openrevoltse/Open-Revolt-SE/Projeto Open revolt SE - Controlador Cougar/Manuais e Imagens/Circuito de Sobrevelocidade.jpg

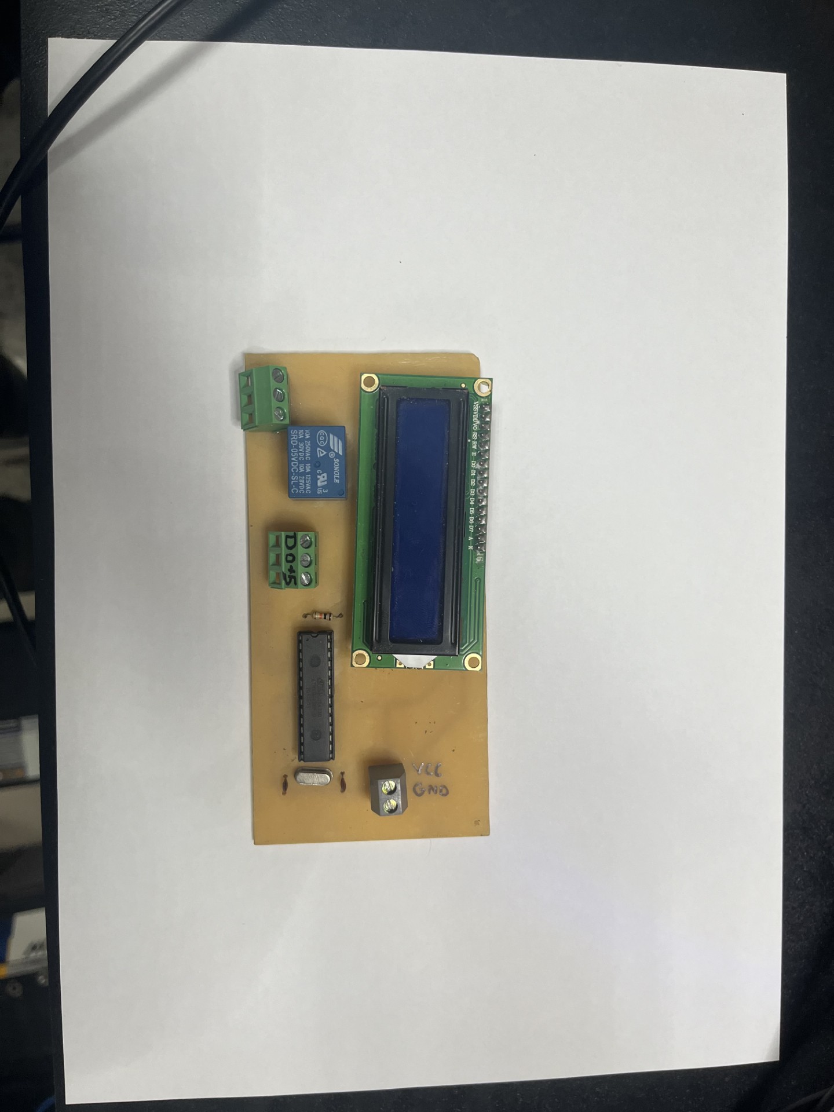
Projeto Open revolt SE - Controlador Cougar/Manuais e Imagens/Circuito de Sobrevelocidade.jpg
