openrevoltse/Open-Revolt-SE/Projeto Open revolt SE - Controlador Cougar/Esquemáticos/Proteção de Sobrevelocidade/Esquema Tacometro parte 2 - Copia.pdf

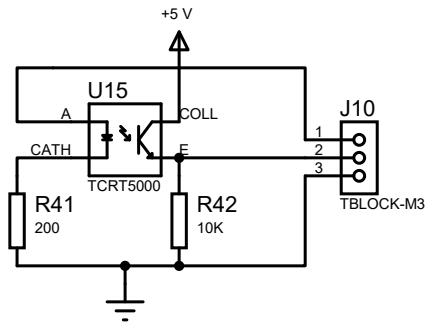
[picture p3: figure]
CATH; COLL; TCRT5000; TBLOCK-M3
