openrevoltse/Open-Revolt-SE/Projeto Open revolt SE - Controlador Cougar/Manuais e Imagens/Compirmento Bobinas rotor.jpg

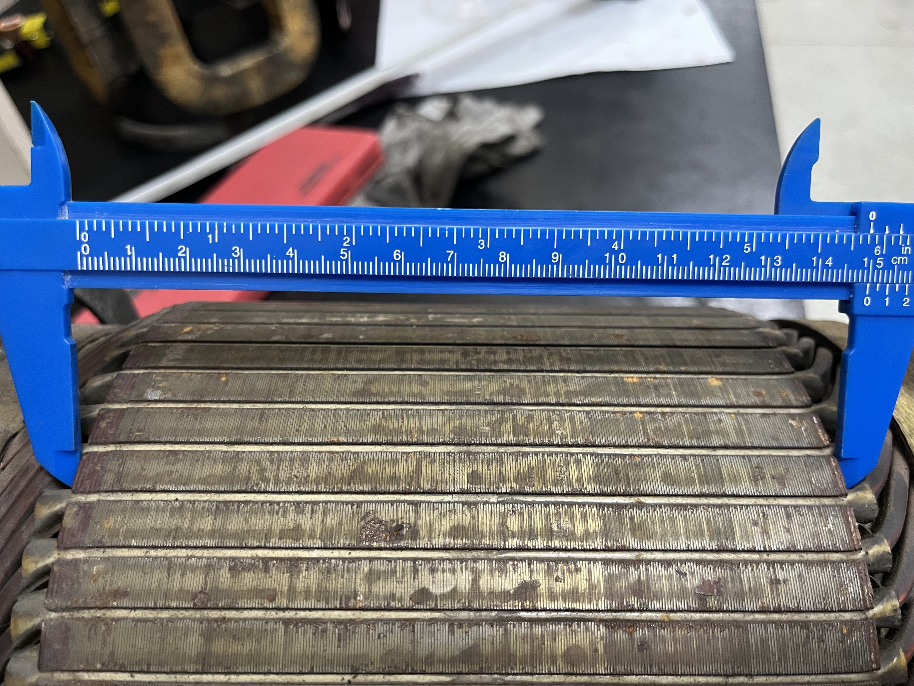
Projeto Open revolt SE - Controlador Cougar/Manuais e Imagens/Compirmento Bobinas rotor.jpg
