openrevoltse/Open-Revolt-SE/Projeto Open revolt SE - Controlador Cougar/Manuais e Imagens/Espessura lamina do rotor.JPG

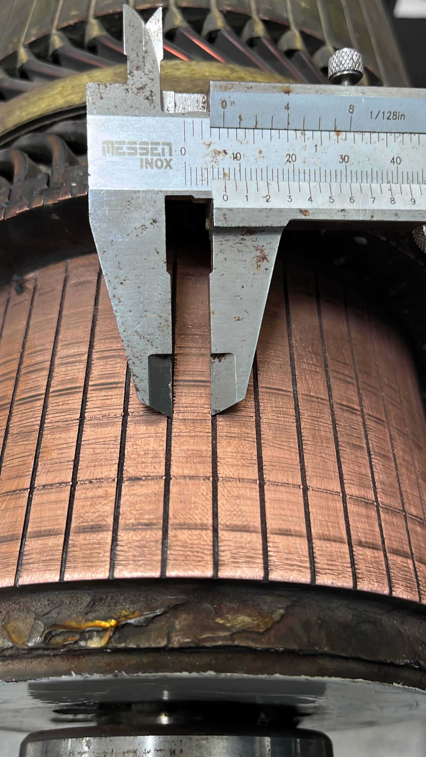
Projeto Open revolt SE - Controlador Cougar/Manuais e Imagens/Espessura lamina do rotor.JPG
