openrevoltse/Open-Revolt-SE/Projeto Open revolt SE - Controlador Cougar/Manuais e Imagens/frente circuito de potencia com dissipador.jpg

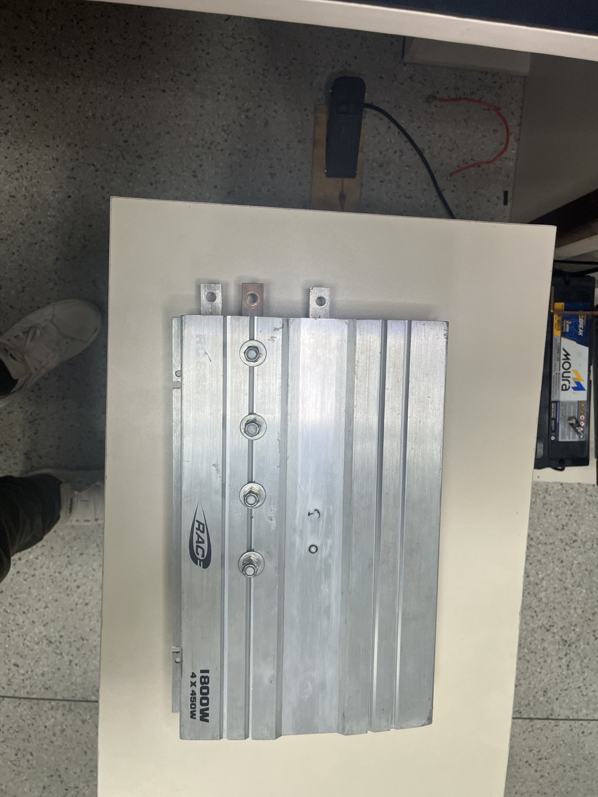
Projeto Open revolt SE - Controlador Cougar/Manuais e Imagens/frente circuito de potencia com dissipador.jpg
