openrevoltse/Open-Revolt-SE/Projeto Open revolt SE - Controlador Cougar/Manuais e Imagens/Mosfets na PCB.jpg

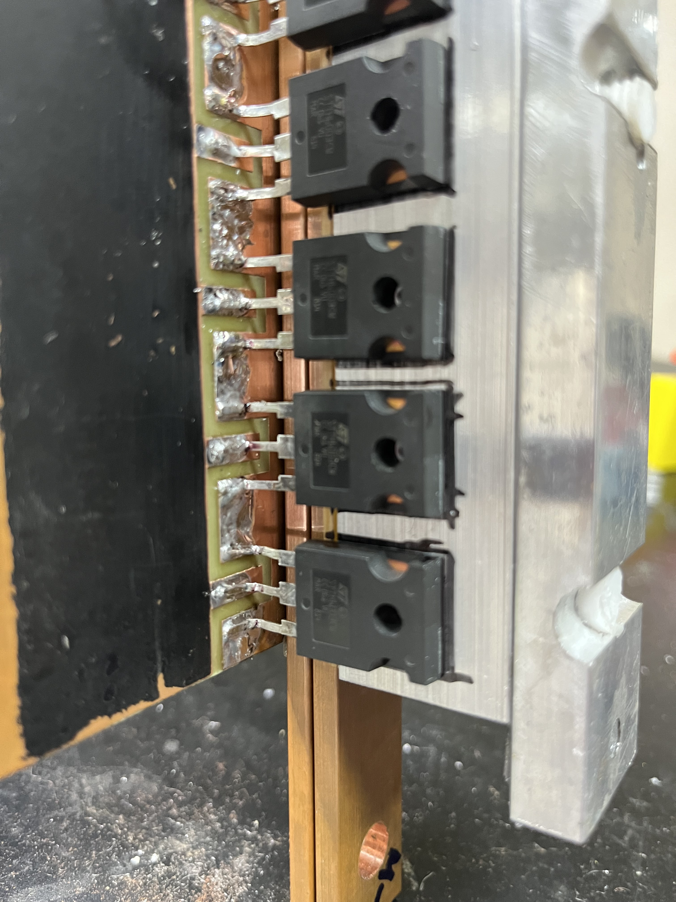
Projeto Open revolt SE - Controlador Cougar/Manuais e Imagens/Mosfets na PCB.jpg
