openrevoltse/Open-Revolt-SE/Projeto Open revolt SE - Controlador Cougar/Manuais e Imagens/PCB potencia Verso.JPG

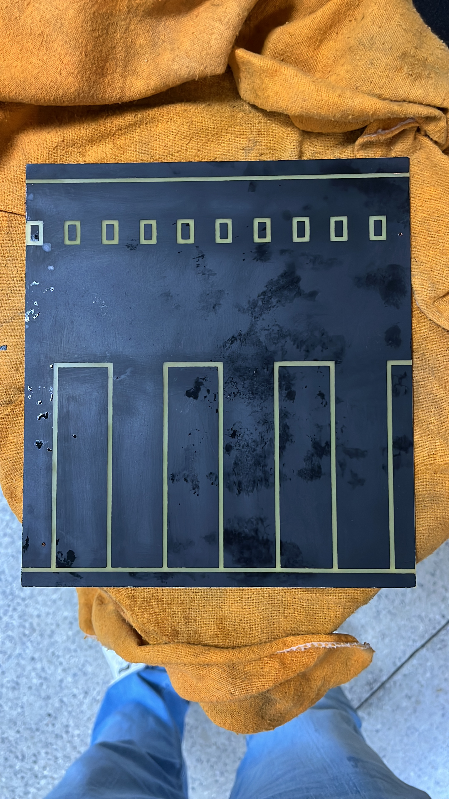
Projeto Open revolt SE - Controlador Cougar/Manuais e Imagens/PCB potencia Verso.JPG
