openrevoltse/Open-Revolt-SE/Projeto Open revolt SE - Controlador Cougar/Manuais e Imagens/PCB potencoa frente.JPG

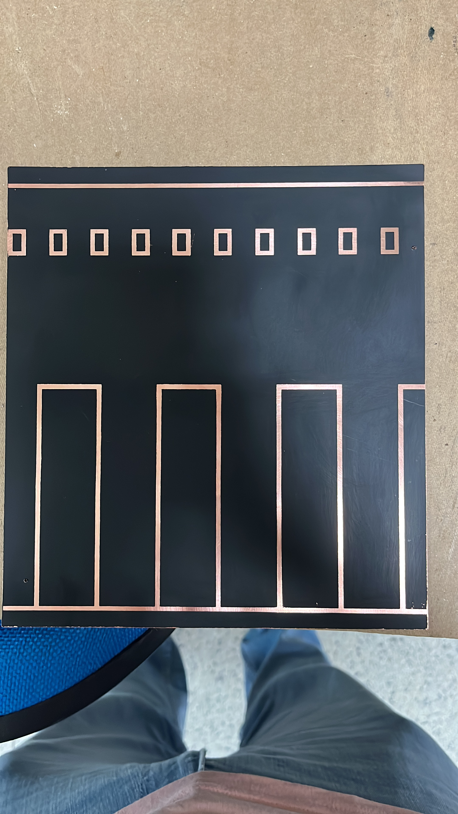
Projeto Open revolt SE - Controlador Cougar/Manuais e Imagens/PCB potencoa frente.JPG
