openrevoltse/Open-Revolt-SE/Projeto Open revolt SE - Controlador Cougar/Manuais e Imagens/Placa de controle.jpg

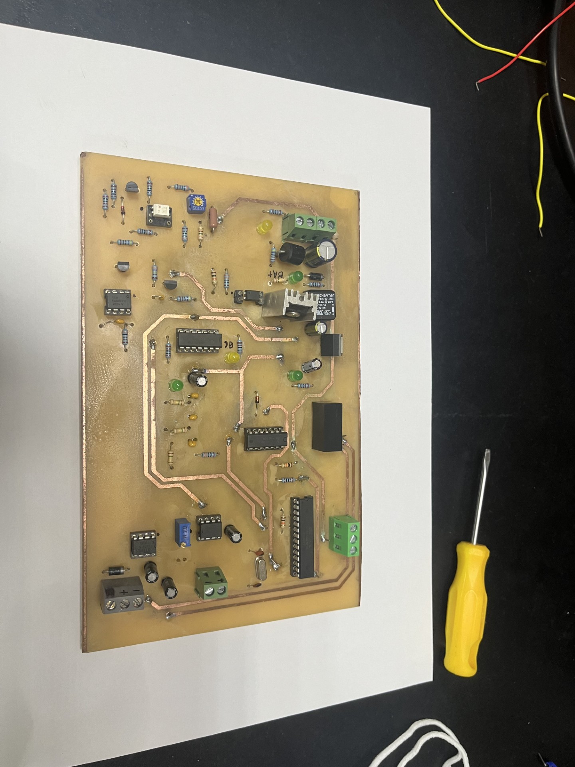
Projeto Open revolt SE - Controlador Cougar/Manuais e Imagens/Placa de controle.jpg
