openrevoltse/Open-Revolt-SE/Projeto Open revolt SE - Controlador Cougar/Manuais e Imagens/verso circuito de potencia.jpg

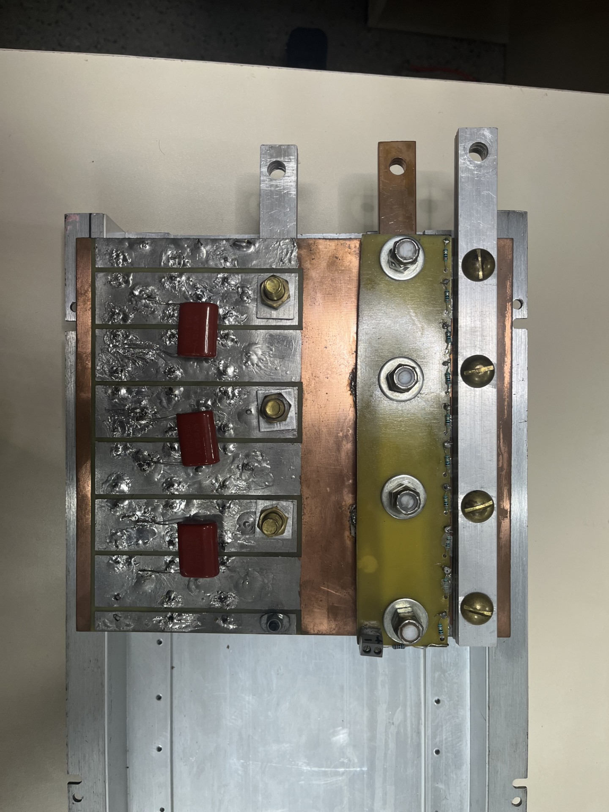
Projeto Open revolt SE - Controlador Cougar/Manuais e Imagens/verso circuito de potencia.jpg
