openrevoltse/Open-Revolt-SE/Projeto Original - Controlador Cougar/Manuais e Imagens/120px-Revolt_color.jpg

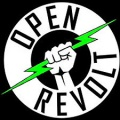
Projeto Original - Controlador Cougar/Manuais e Imagens/120px-Revolt_color.jpg
