openrevoltse/Open-Revolt-SE/Projeto Original - Controlador Cougar/Manuais e Imagens/1000Amp_bicicleta.webp

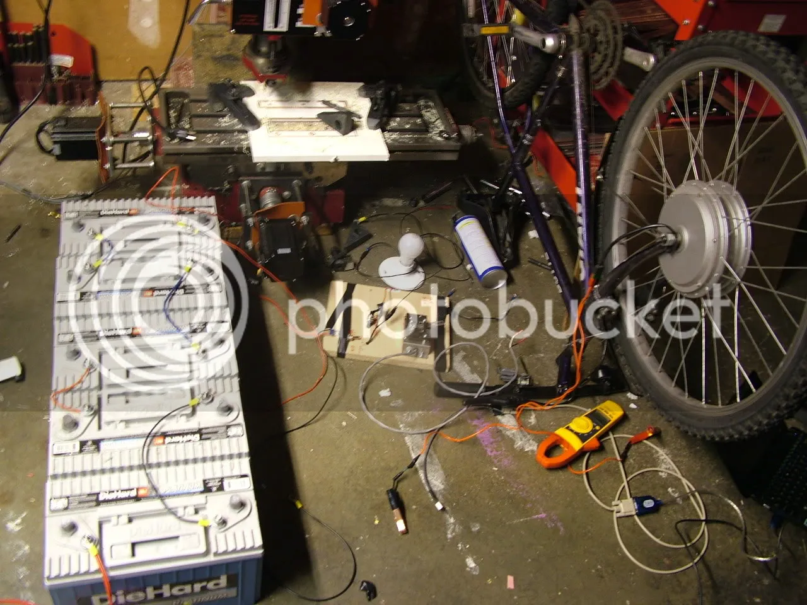
Projeto Original - Controlador Cougar/Manuais e Imagens/1000Amp_bicicleta.webp
