openrevoltse/Open-Revolt-SE/Projeto Original - Controlador Cougar/Manuais e Imagens/1000Amp_Controlador.webp

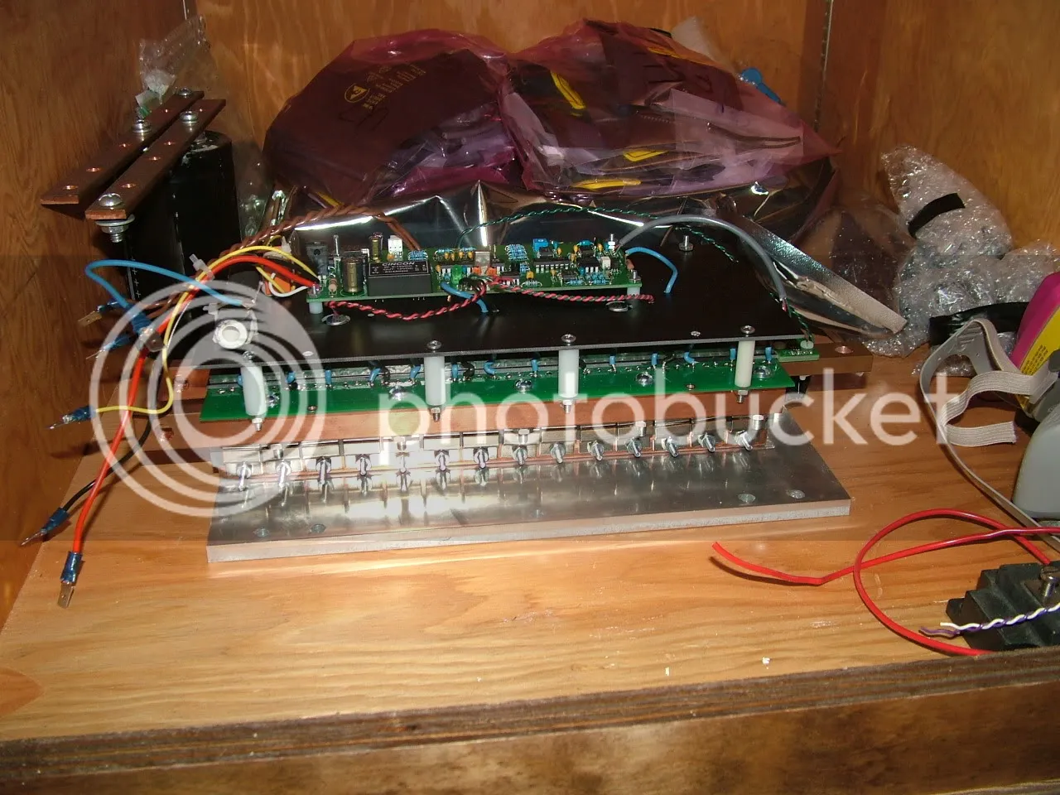
Projeto Original - Controlador Cougar/Manuais e Imagens/1000Amp_Controlador.webp
