openrevoltse/Open-Revolt-SE/Projeto Original - Controlador Cougar/Manuais e Imagens/20160929_200047.jpg

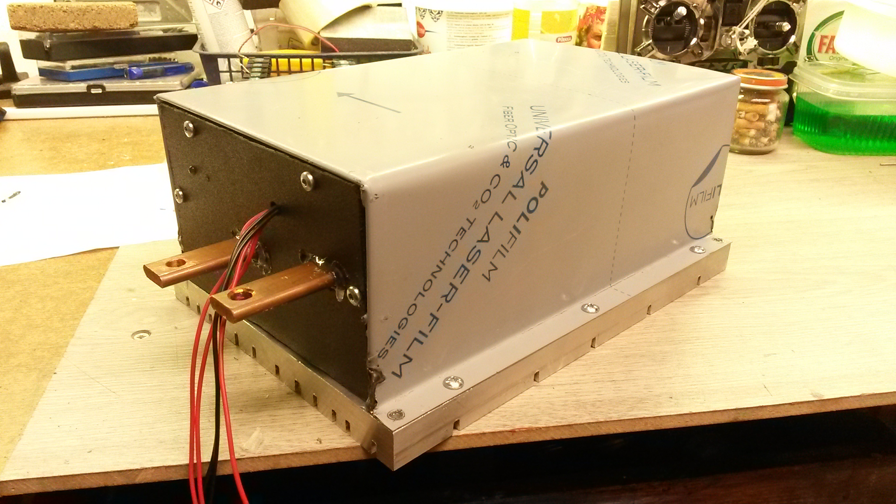
Projeto Original - Controlador Cougar/Manuais e Imagens/20160929_200047.jpg
