openrevoltse/Open-Revolt-SE/Projeto Original - Controlador Cougar/Manuais e Imagens/20160929_200059.jpg

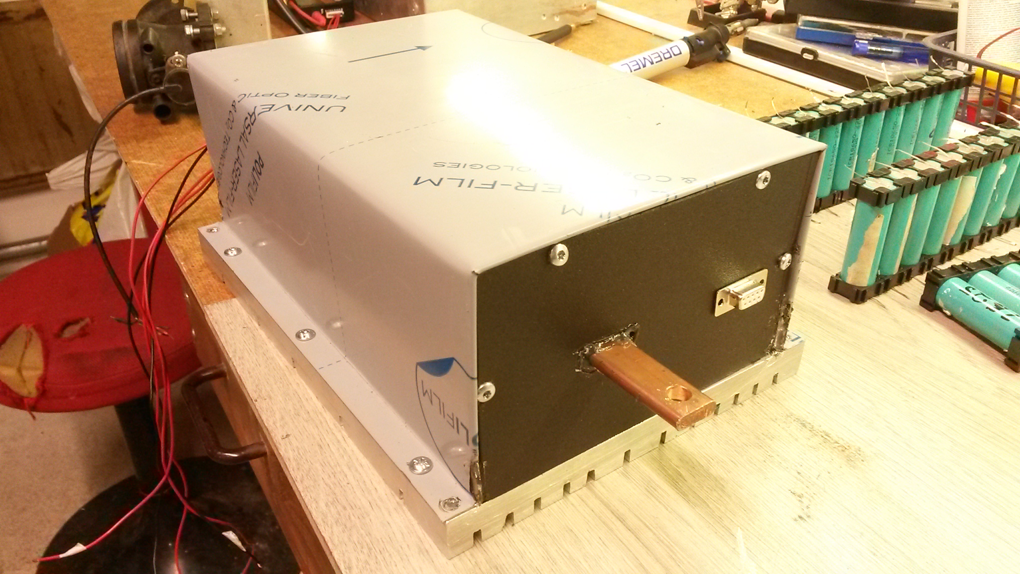
Projeto Original - Controlador Cougar/Manuais e Imagens/20160929_200059.jpg
