openrevoltse/Open-Revolt-SE/Projeto Original - Controlador Cougar/Manuais e Imagens/Parte inferior do capacitores+mosfet versao1.PNG

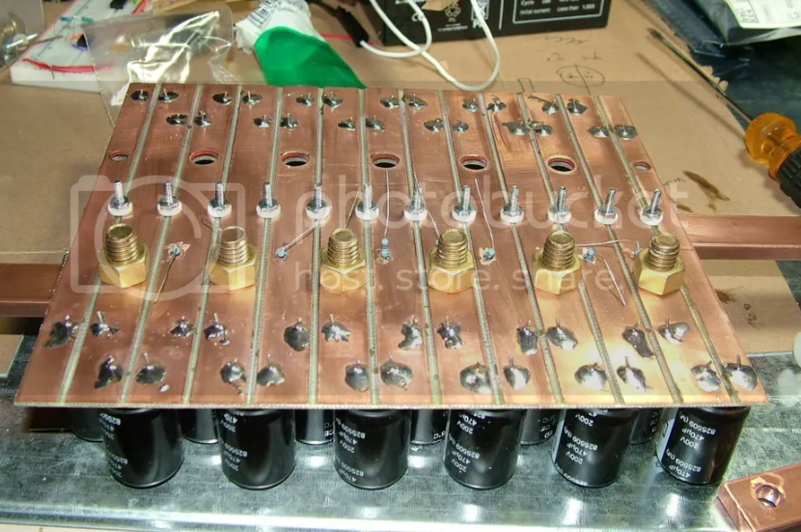
Projeto Original - Controlador Cougar/Manuais e Imagens/Parte inferior do capacitores+mosfet versao1.PNG
