openrevoltse/Open-Revolt-SE/Projeto Original - Controlador Cougar/Manuais e Imagens/Parte superior do capacitores+mosfet versao1.PNG

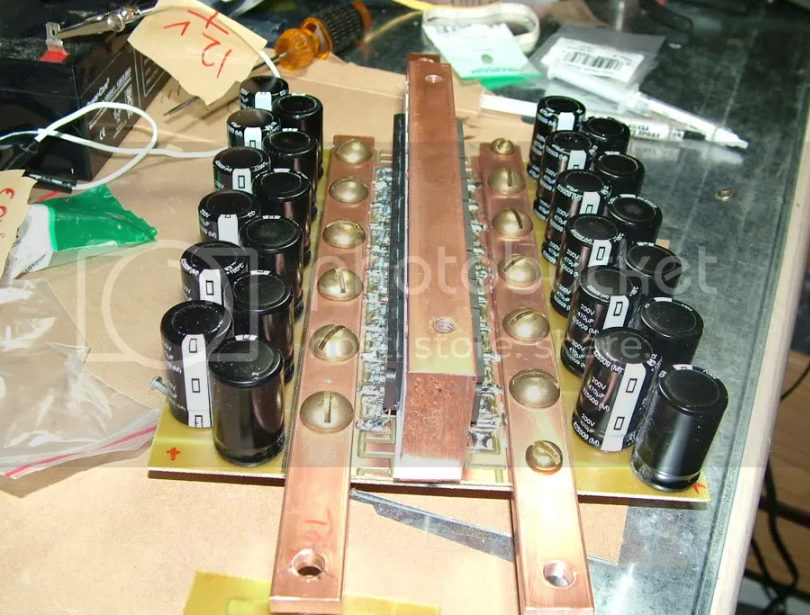
Projeto Original - Controlador Cougar/Manuais e Imagens/Parte superior do capacitores+mosfet versao1.PNG
