openrevoltse/Open-Revolt-SE/Projeto Original - Controlador Cougar/Manuais e Imagens/visaoGeral Circuito de bancada versao1.0.PNG

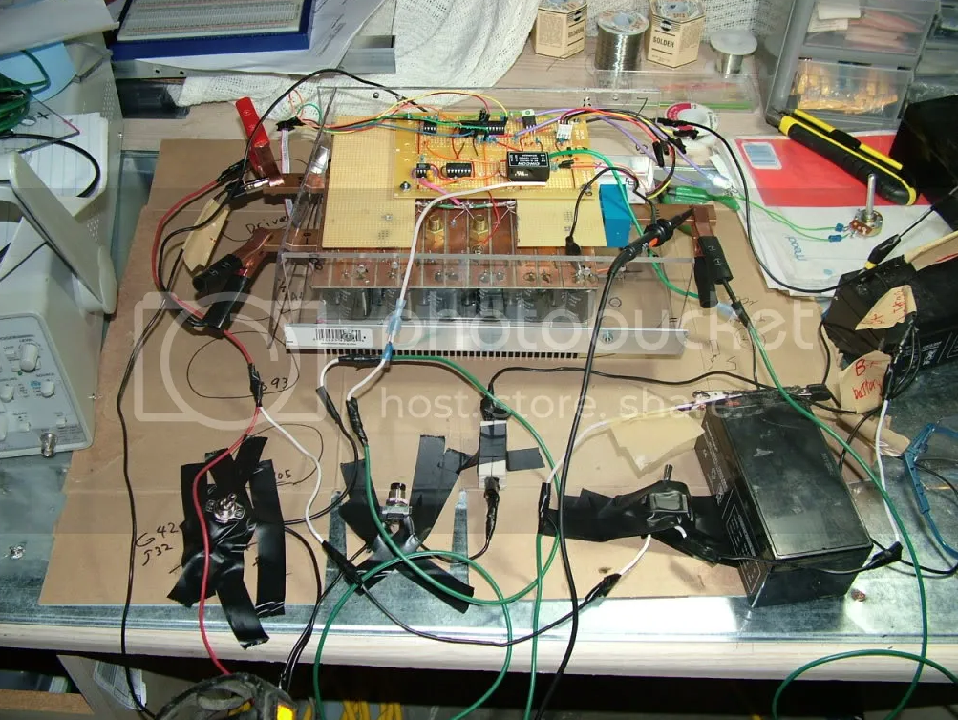
Projeto Original - Controlador Cougar/Manuais e Imagens/visaoGeral Circuito de bancada versao1.0.PNG
