openrevoltse/Open-Revolt-SE/Projeto Original - Controlador Cougar/Esquematico re2C/Cougar Controller_2D_1.pdf

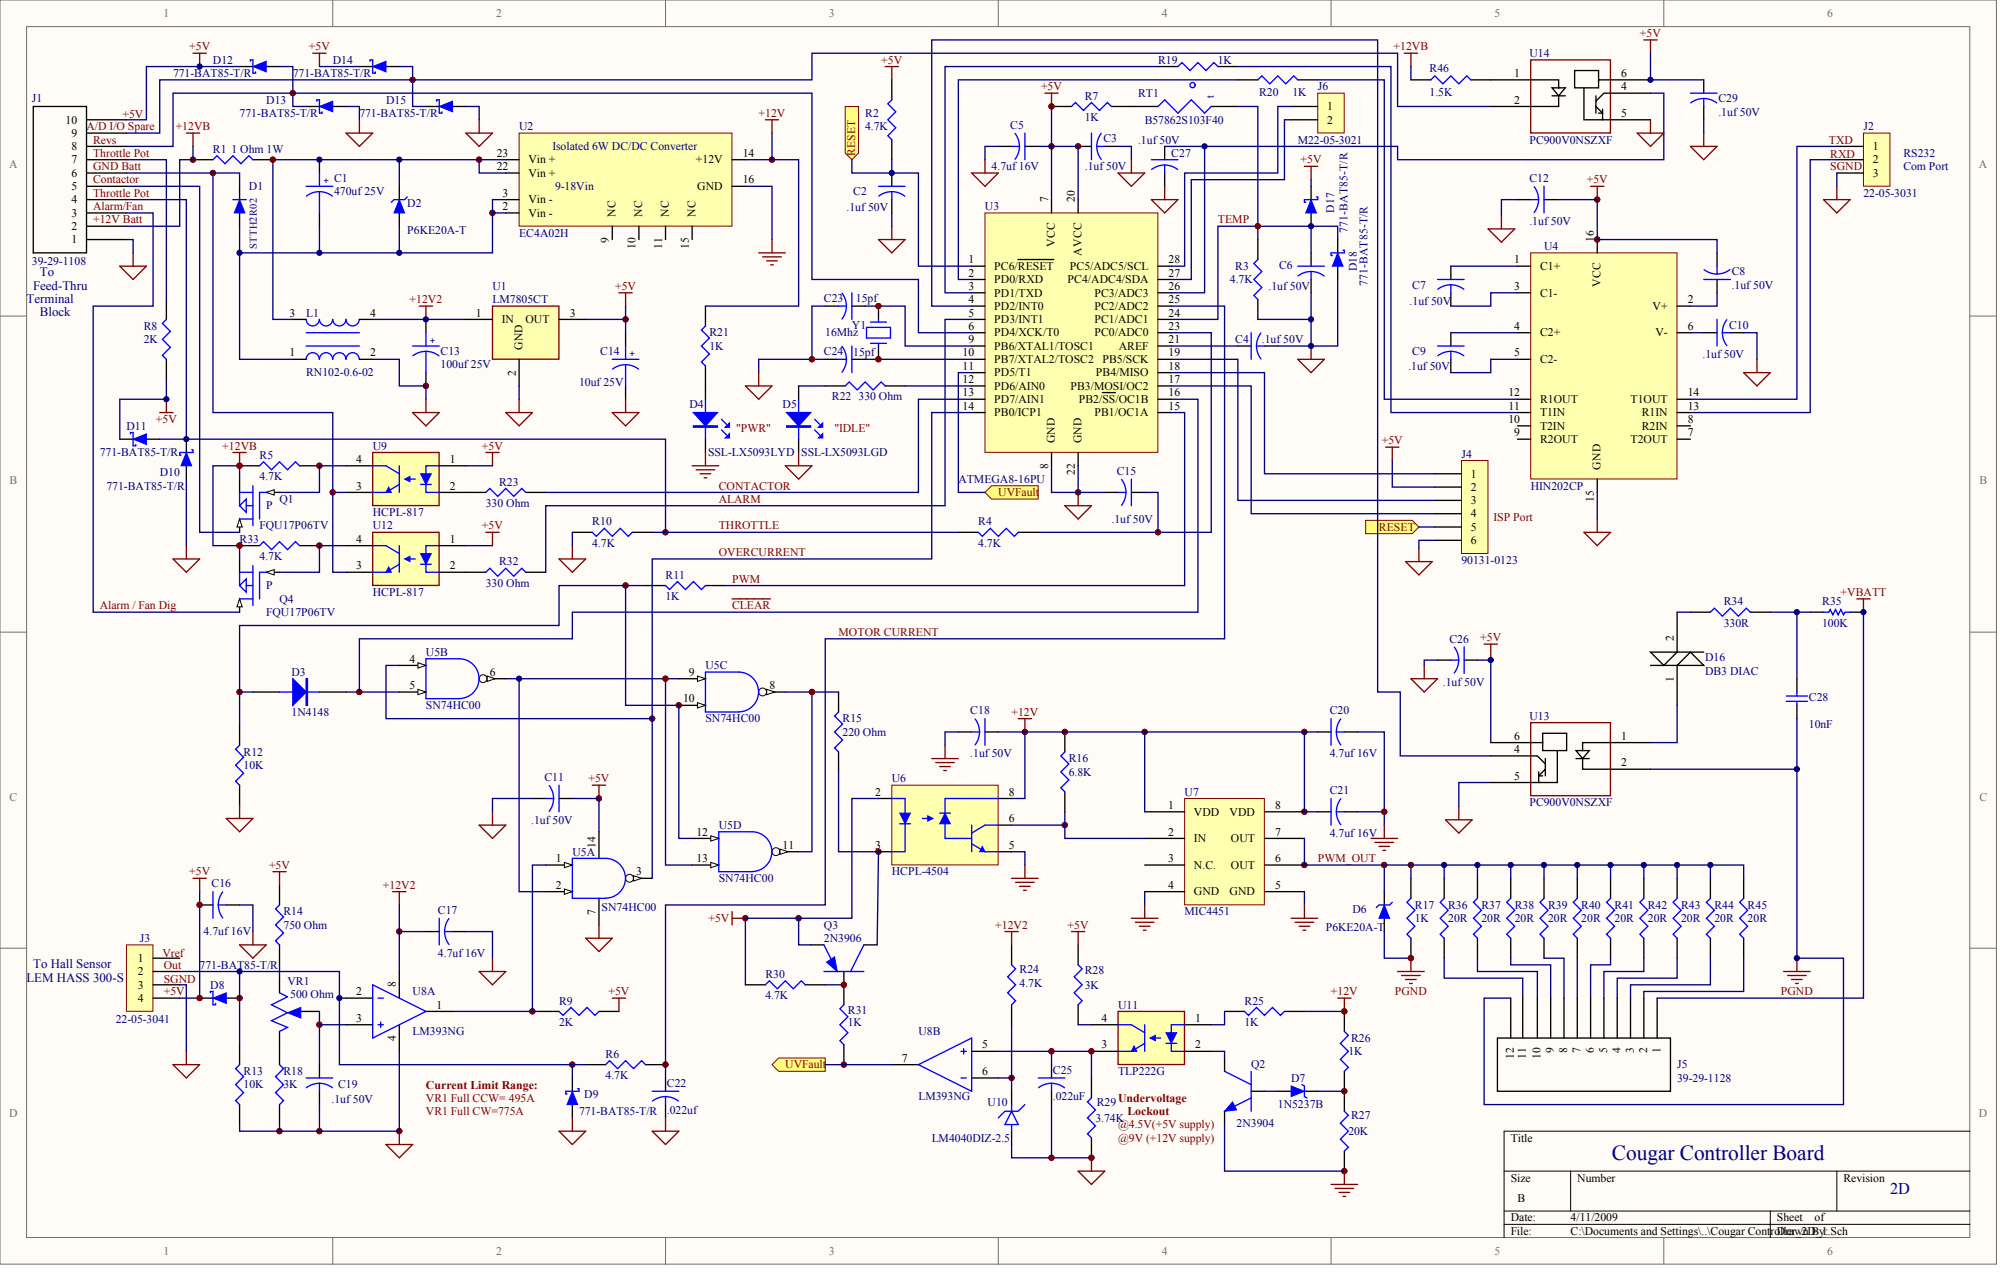
[picture p23: page 1]

771-BAT85-T/R | 771-BAT85-T/R

Isolated 6W DC/DC Converter

HCPL-817 P Q1

MOTOR CURRENT N0MOTOR CURRENT N0MOTOR CURRENT

P0J302 P0J302 P0J302 SGND | D8 | | 500 Ohm
P0J303 P0J303 P0J303 +5V
