openrevoltse/Open-Revolt-SE/Projeto Open revolt SE - Controlador Cougar/Esquemáticos/Circuito de Controle/Circuito de Controle Parte 1.pdf

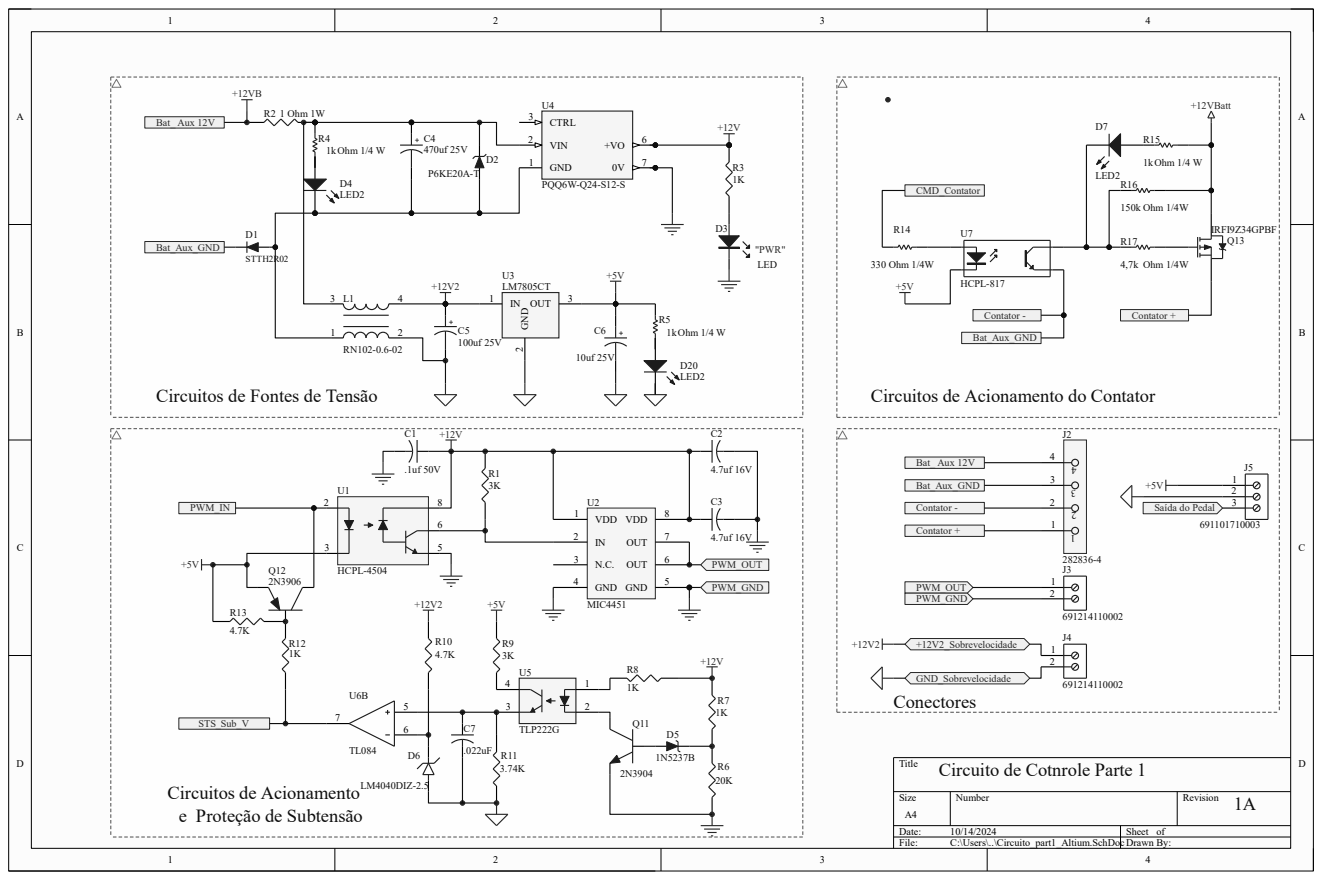
[picture p24: page 1]

Circuitos de Fontes de Tensão

Circuitos de Acionamento do Contator

Title
Circuito de Cotnrole Parte 1
