openrevoltse/Open-Revolt-SE/Projeto Open revolt SE - Controlador Cougar/Esquemáticos/Circuito de Controle/Circuito de Controle Parte 2.pdf

6 11 4

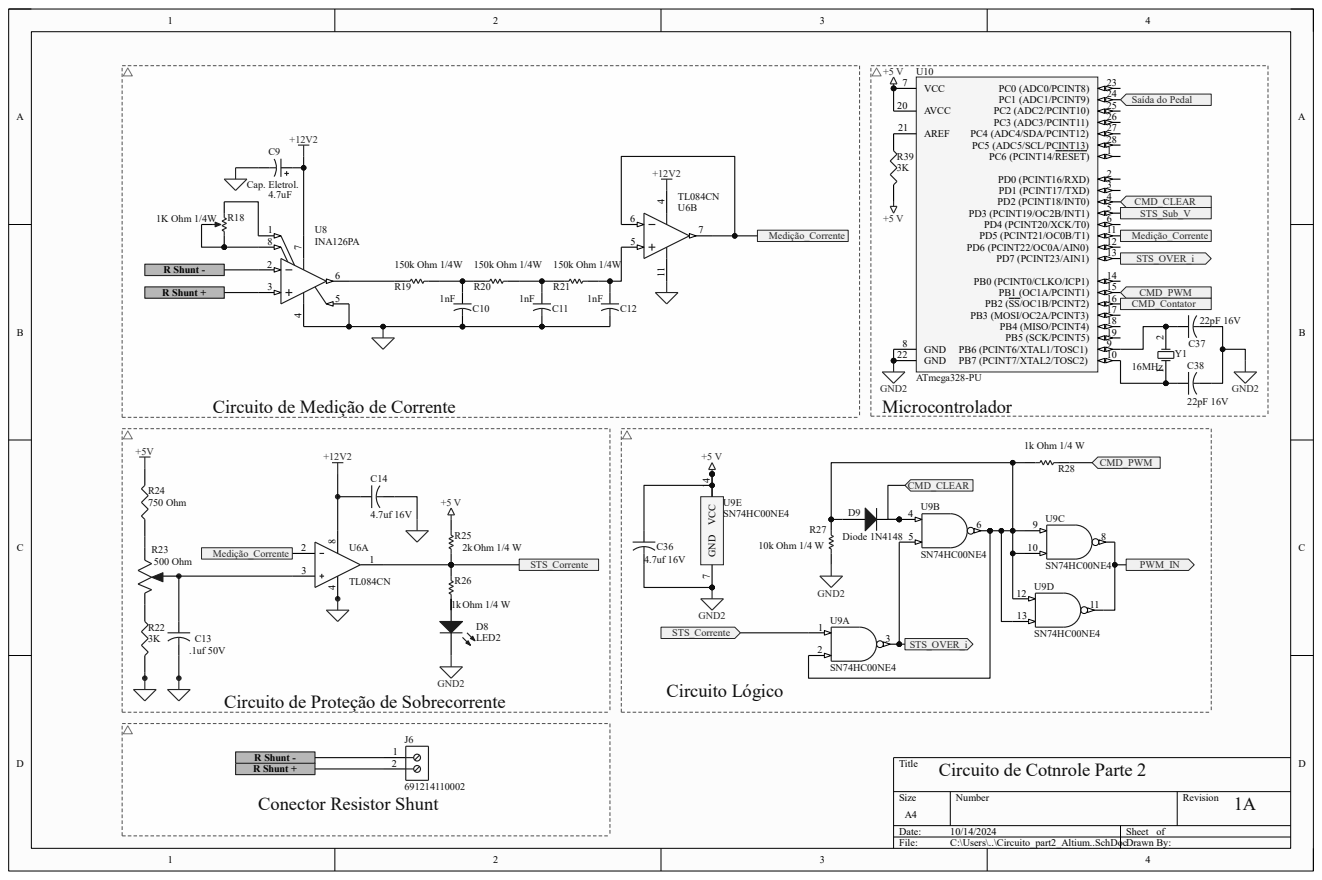
[picture p25: page 1]

Circuito de Medição de Corrente

Microcontrolador VCC ¹⁴ GND

Title
Circuito de Cotnrole Parte 2
