openrevoltse/Open-Revolt-SE/Projeto Original - Controlador Cougar/Layout PCB Altium/Circuito de Potência/Cougar Power_1d_bottom.pdf

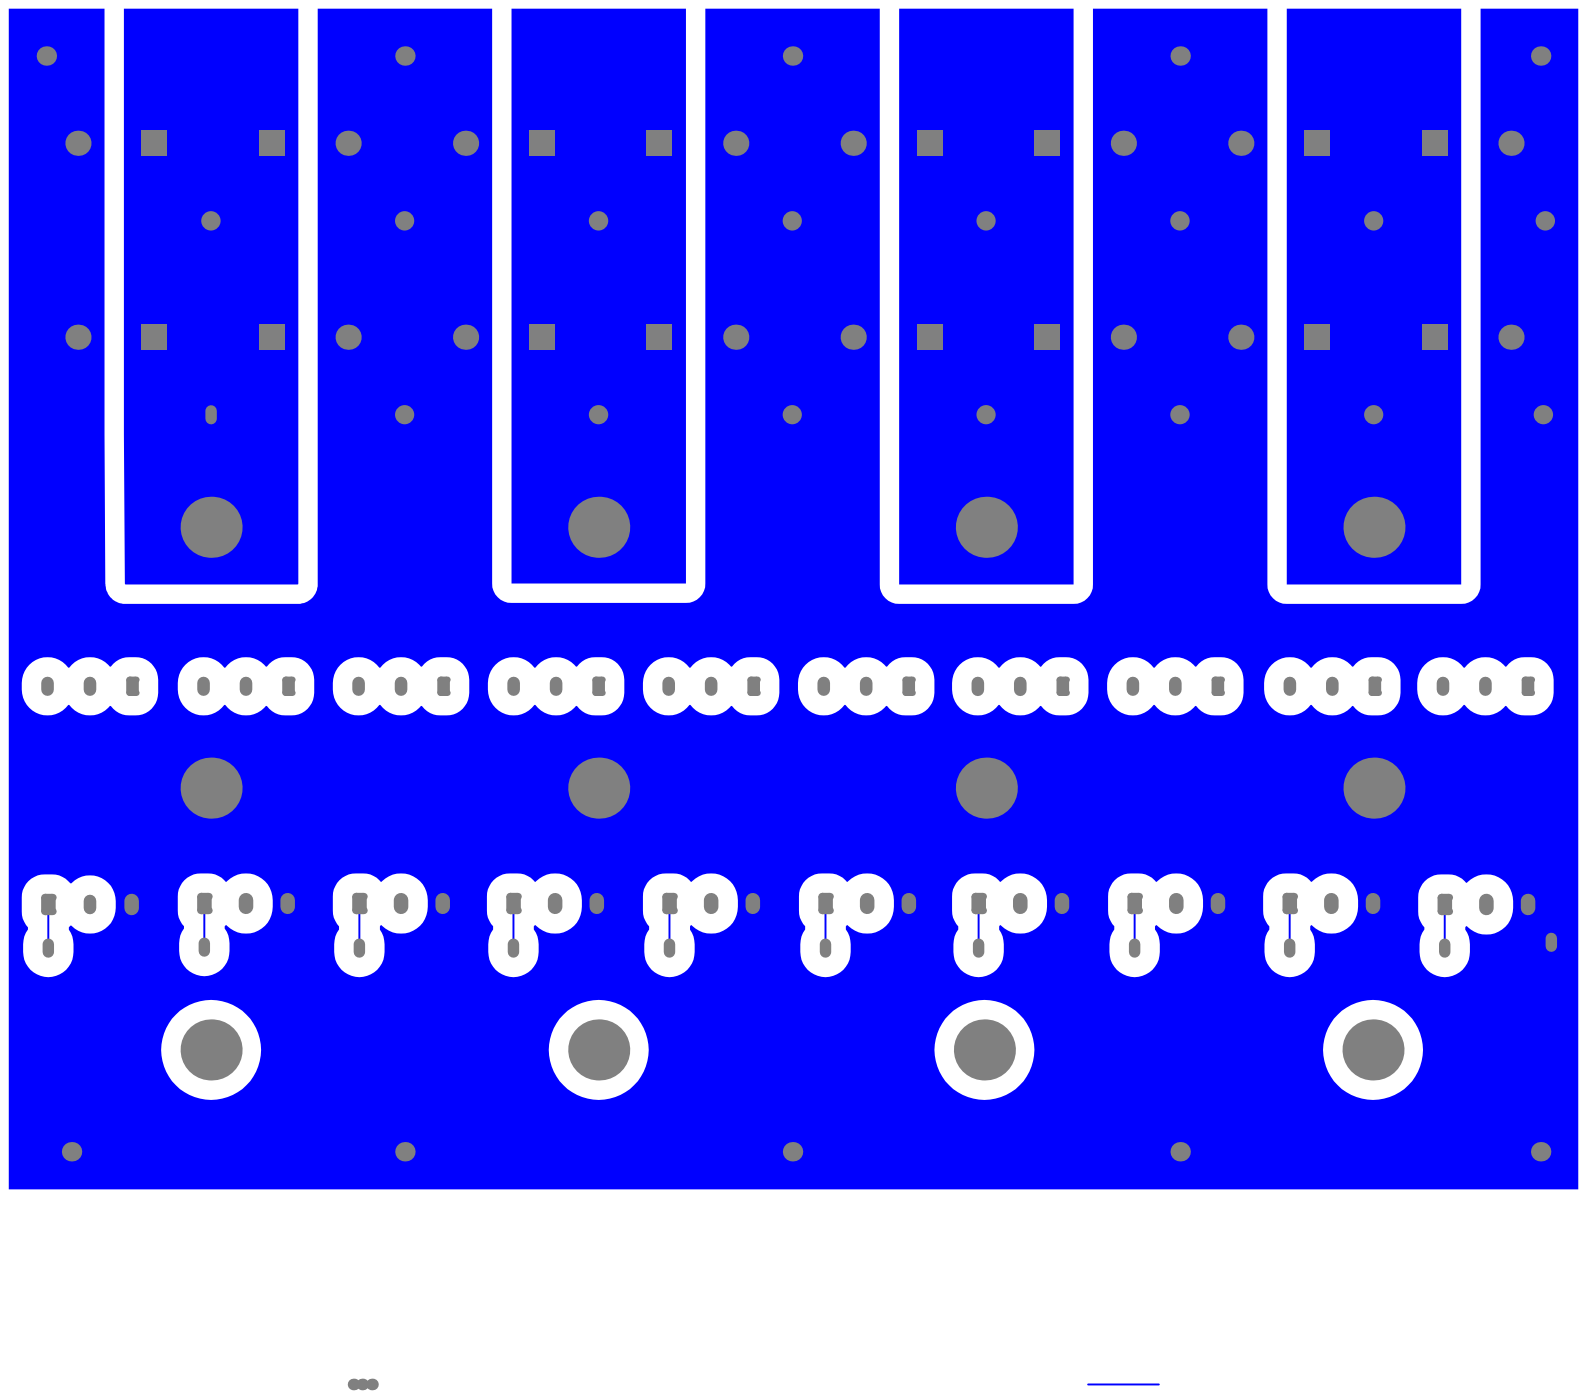
[picture p26: page 1]
