openrevoltse/Open-Revolt-SE/Projeto Original - Controlador Cougar/Layout PCB Altium/Circuito de Potência/Cougar Power_1doverlay.pdf

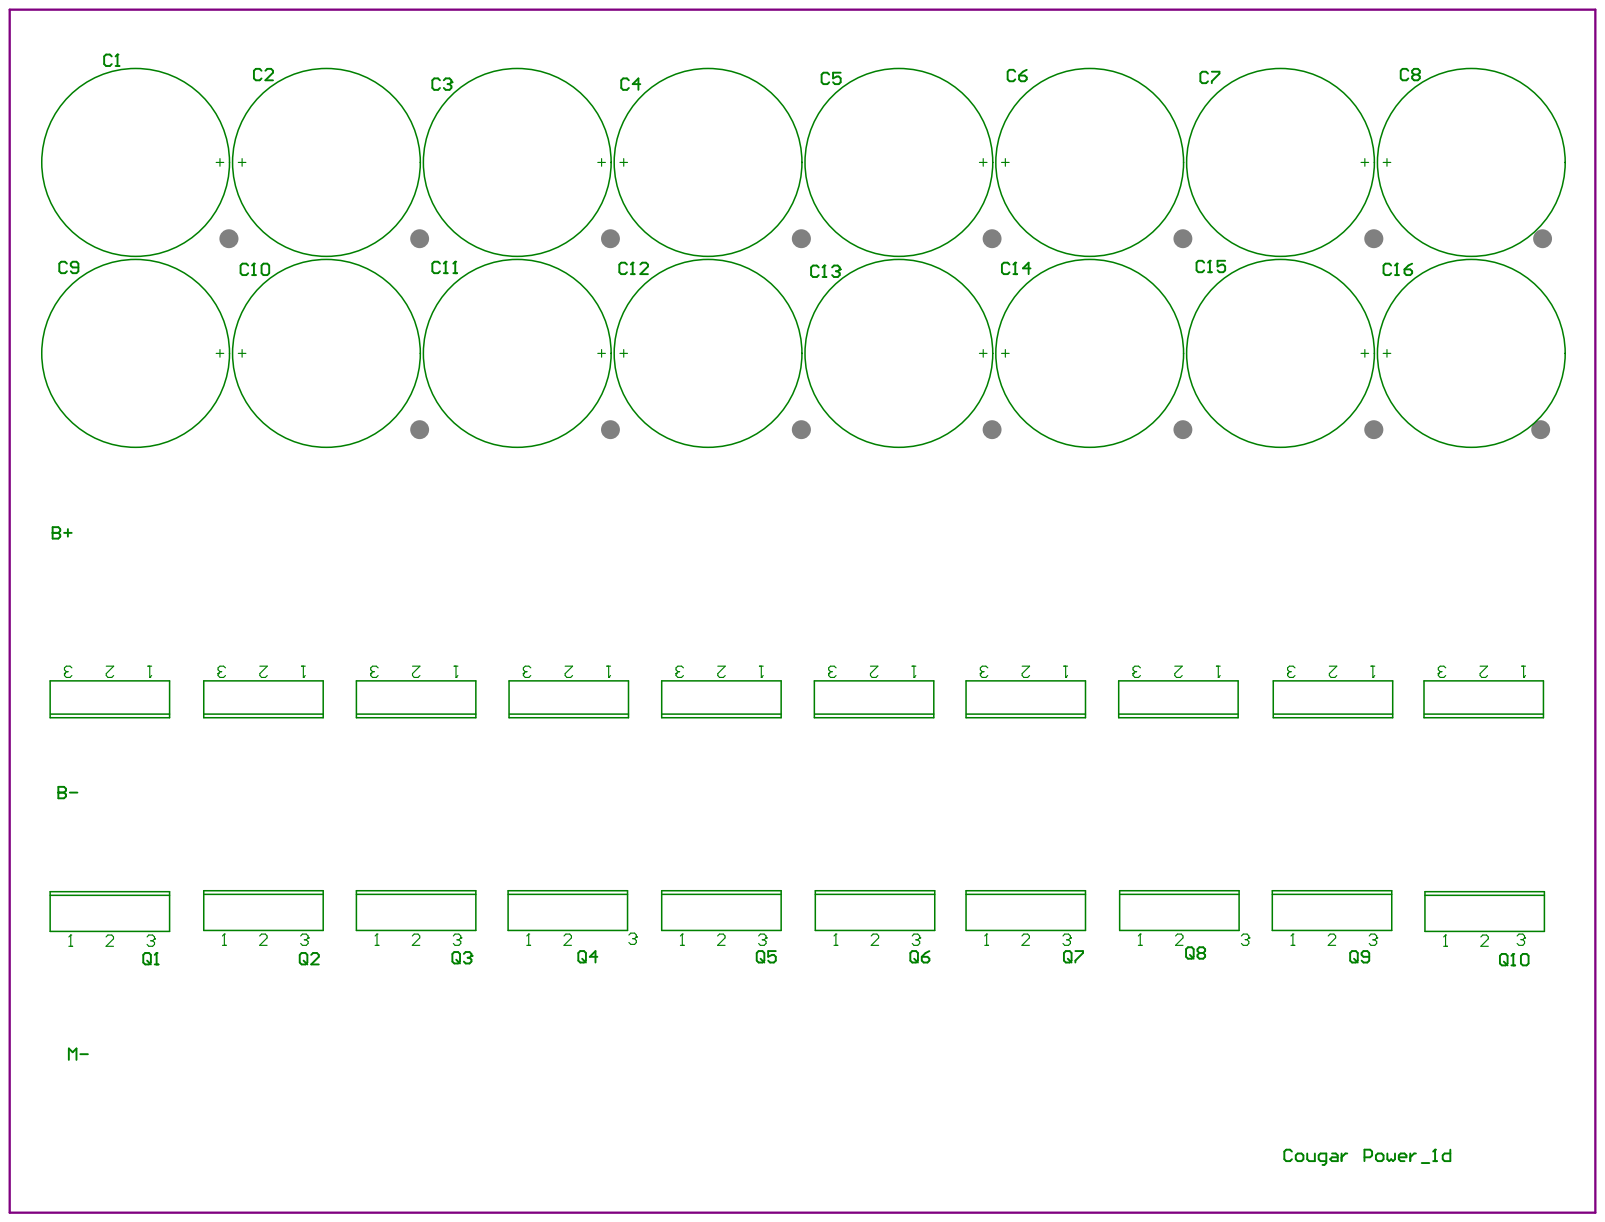
[picture p27: page 1]
