openrevoltse/Open-Revolt-SE/Projeto Original - Controlador Cougar/Layout PCB Altium/Circuito de Potência/Cougar Power_1dtop.pdf

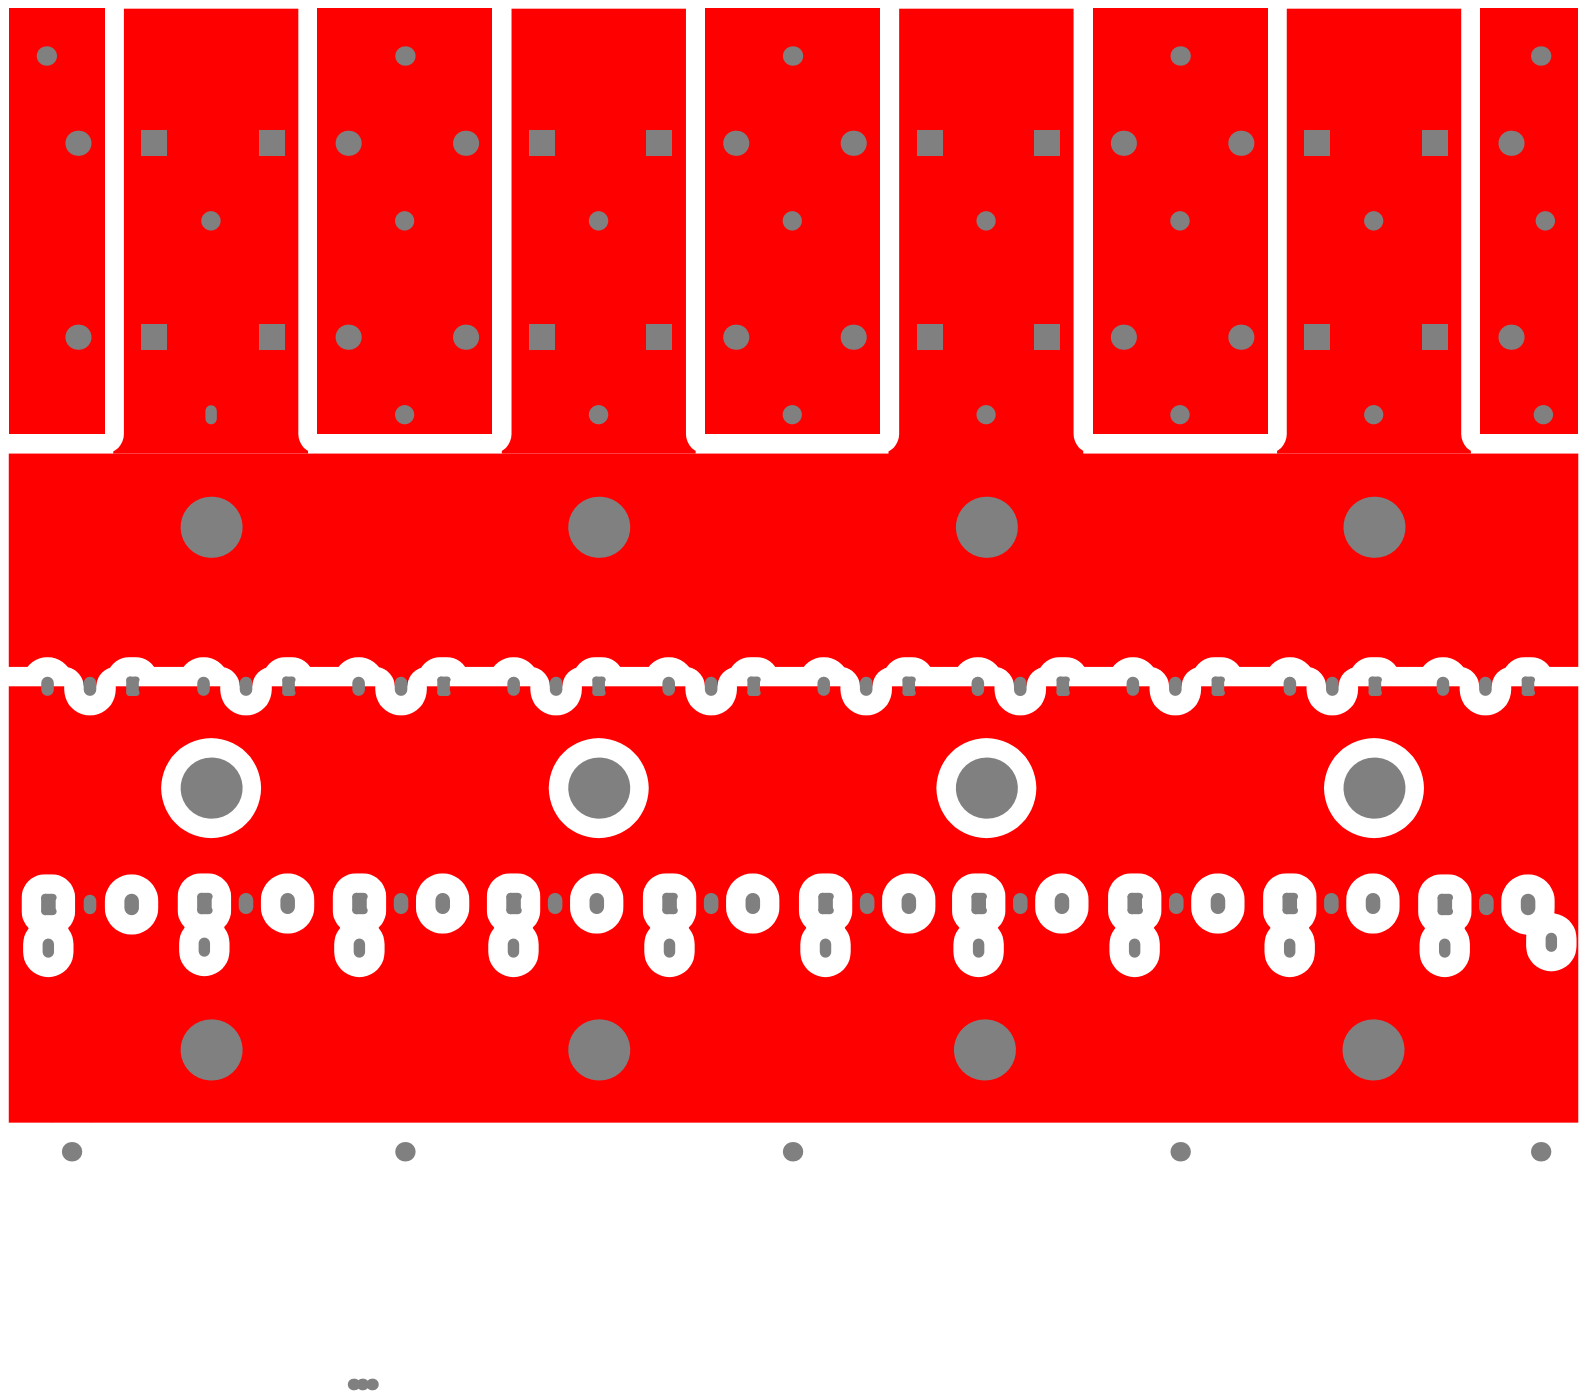
[picture p28: page 1]
