openrevoltse/Open-Revolt-SE/Projeto Open revolt SE - Controlador Cougar/Layout PCBs Altium/Proteção de Sobrevelocidade/PCB Tacometro parte 1.pdf

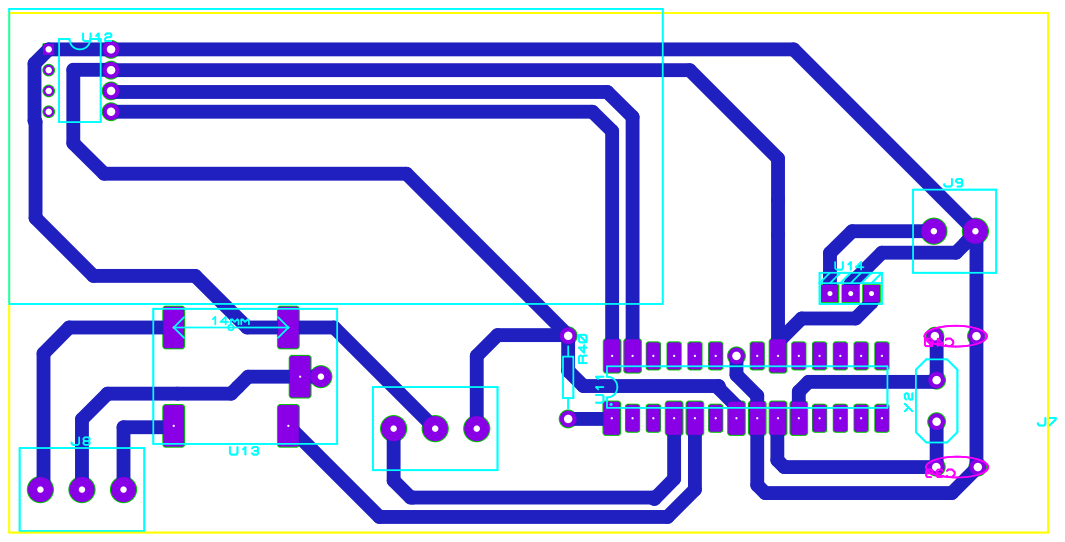
[picture p29: page 1]
