openrevoltse/Open-Revolt-SE/Projeto Open revolt SE - Controlador Cougar/Layout PCBs Altium/Proteção de Sobrevelocidade/PCB Tacometro parte 2.pdf

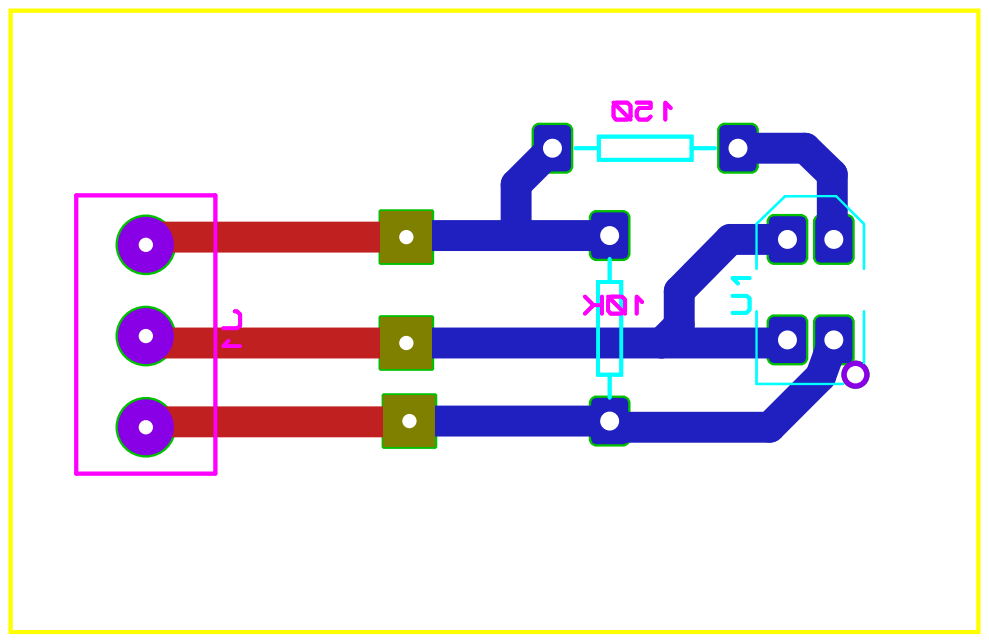
[picture p30: page 1]
