openrevoltse/Open-Revolt-SE/Projeto Open revolt SE - Controlador Cougar/Layout PCBs Altium/Circuito de Potência/PDF_A4 layout PCB FRENTE- Circuito de potencia (VERSAO FINAL).pdf

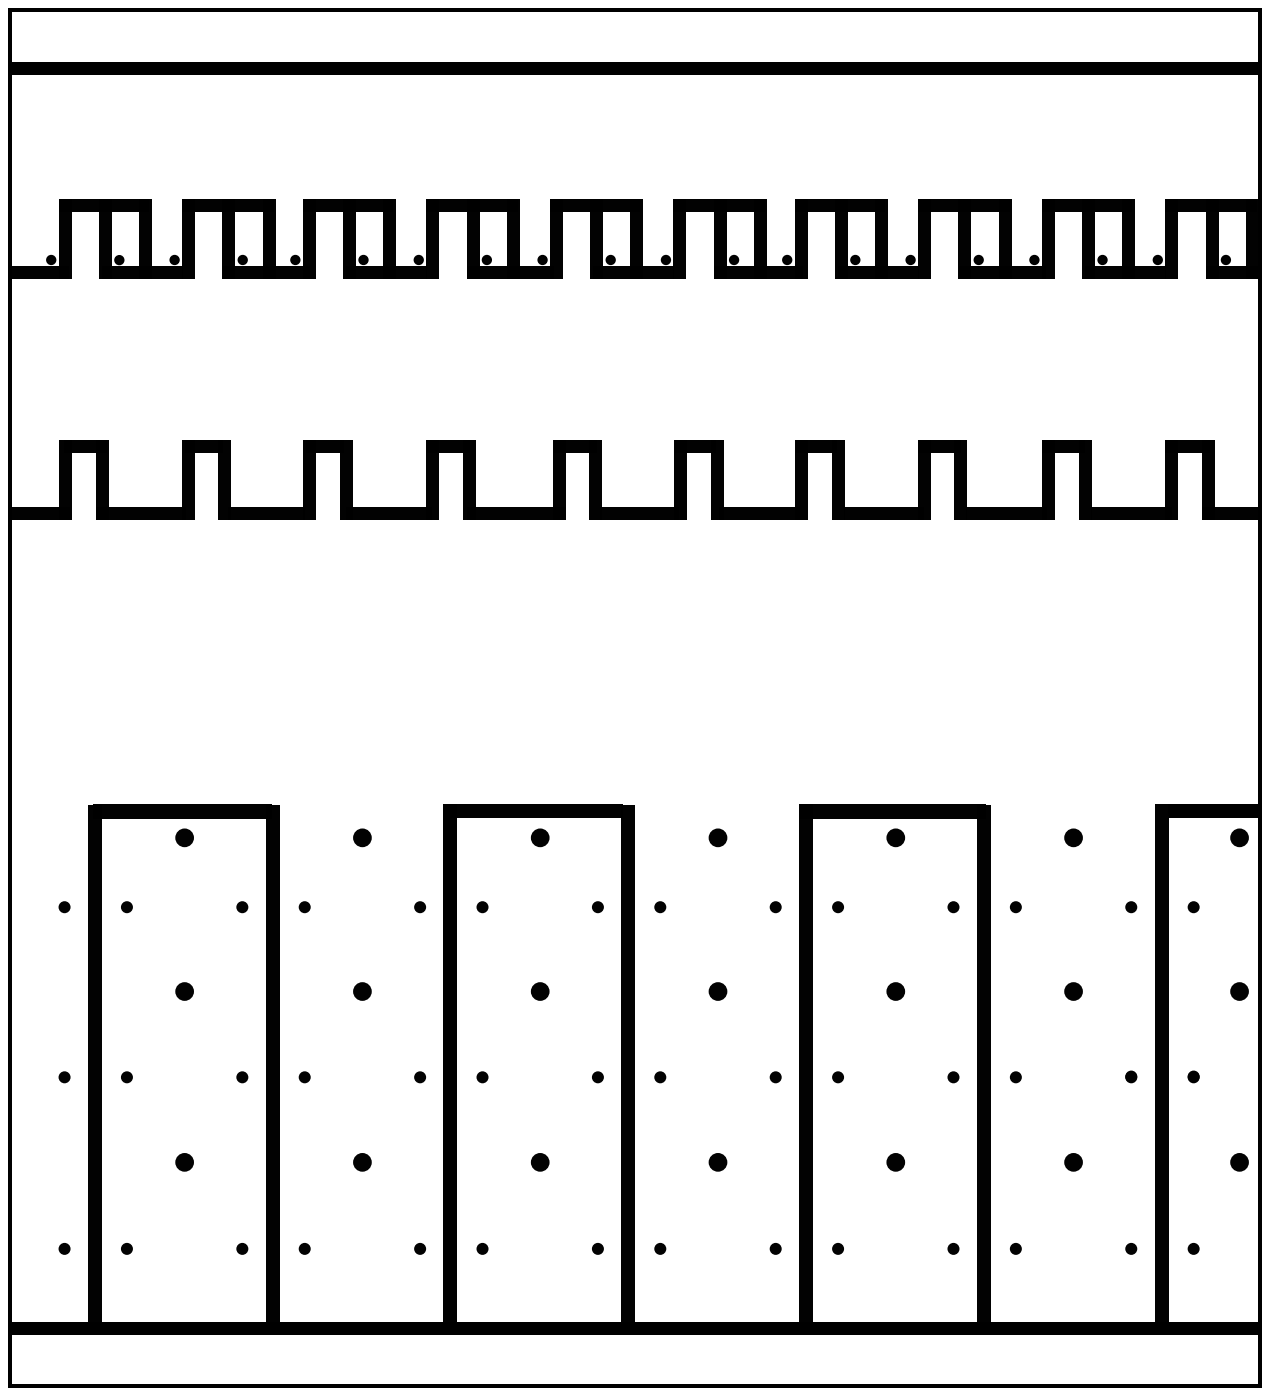
[picture p31: page 1]
