openrevoltse/Open-Revolt-SE/Projeto Open revolt SE - Controlador Cougar/Layout PCBs Altium/Circuito de Controle/PCB CONTROLE.pdf

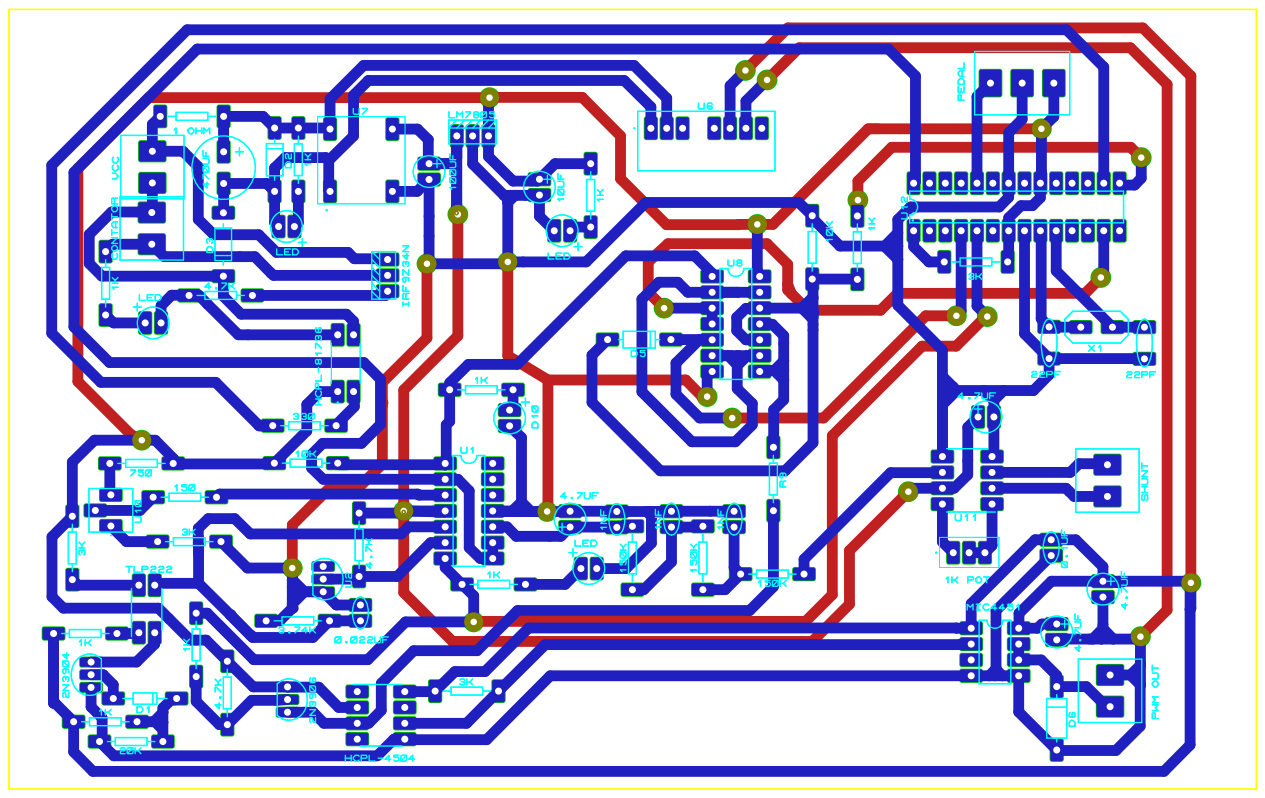
[picture p32: page 1]
