openrevoltse/Open-Revolt-SE/Projeto Open revolt SE - Controlador Cougar/Esquemáticos/Proteção de Sobrevelocidade/Esquema Tacometro parte 1.pdf

C40

C39

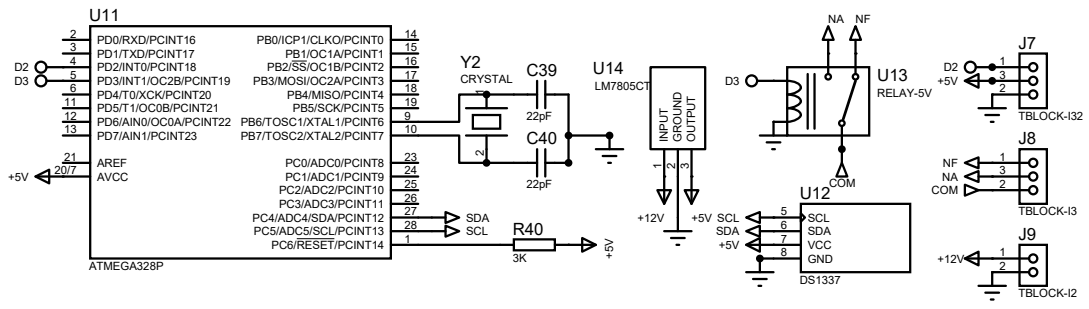
[picture p33: page 1]
