openrevoltse/Open-Revolt-SE/Projeto Open revolt SE - Controlador Cougar/Esquemáticos/Circuito de Potência/Cougar Power_SE_Altium.pdf

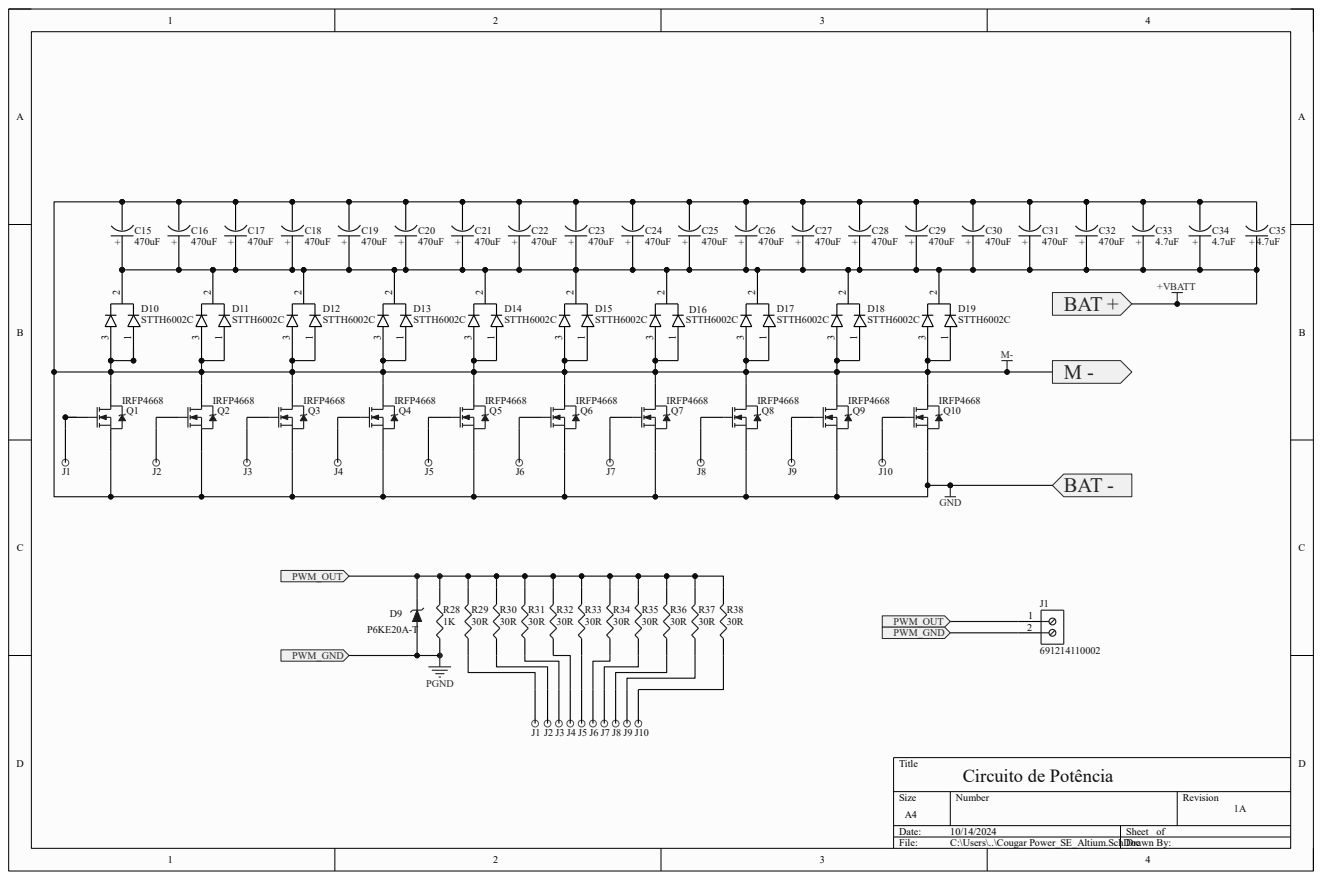
[picture p34: page 1]
