openrevoltse/Open-Revolt-SE/(list of files, drawings)

Other design files:
Projeto Open revolt SE - Controlador Cougar/Esquemáticos/Circuito de Controle/Circuito_part1_Altium.SchDoc
Projeto Open revolt SE - Controlador Cougar/Esquemáticos/Circuito de Controle/Circuito_part2_Altium..SchDoc
Projeto Open revolt SE - Controlador Cougar/Esquemáticos/Circuito de Potência/Cougar Power_SE_Altium.SchDoc
Projeto Open revolt SE - Controlador Cougar/Layout PCBs Altium/Circuito de Controle/Projeto_placa_v5.pdsprj
Projeto Open revolt SE - Controlador Cougar/Layout PCBs Altium/Circuito de Potência/Cougar Power_Altium.PcbDoc
Projeto Open revolt SE - Controlador Cougar/Layout PCBs Altium/Proteção de Sobrevelocidade/PCB_Tacometro_Parte2.pdsprj
