openrevoltse/Open-Revolt-SE/Projeto Open revolt SE - Controlador Cougar/Manuais e Imagens/Comprimento lamina rotor.jpg

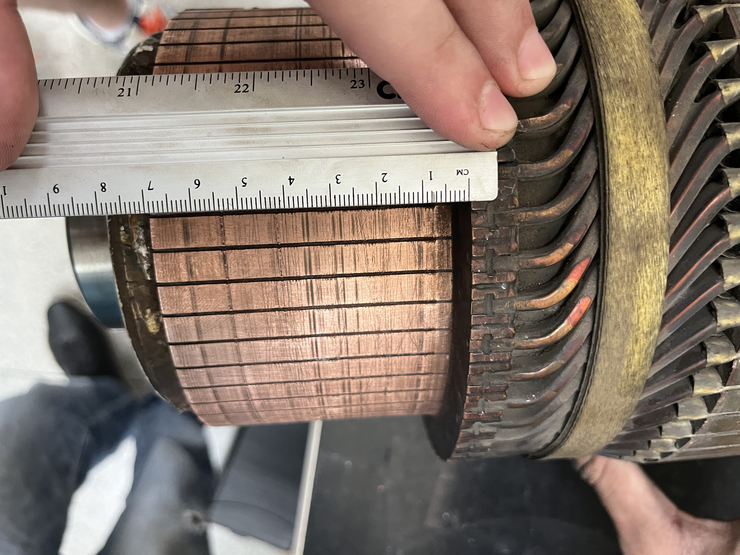
Projeto Open revolt SE - Controlador Cougar/Manuais e Imagens/Comprimento lamina rotor.jpg
