openrevoltse/Open-Revolt-SE/Projeto Open revolt SE - Controlador Cougar/Manuais e Imagens/Espessura bobina rotor.jpg

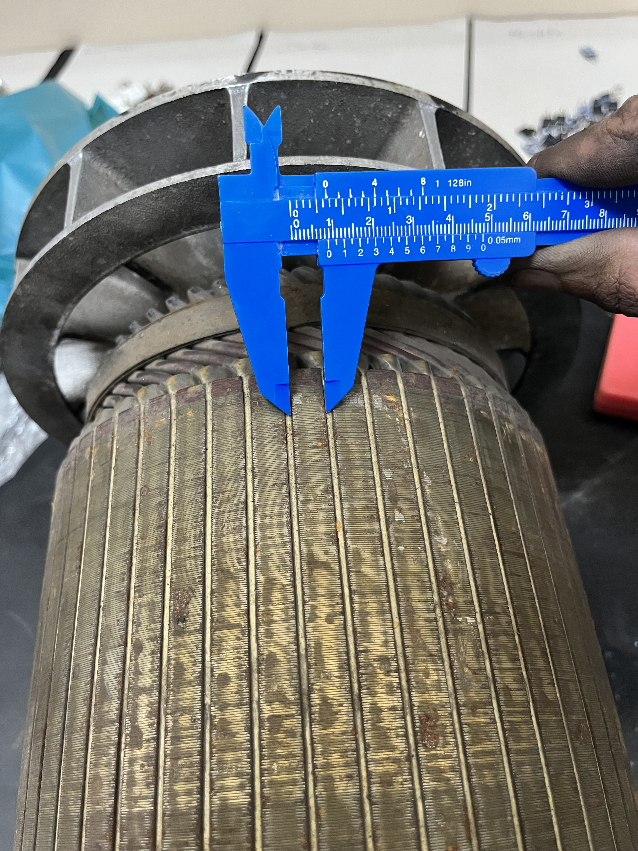
Projeto Open revolt SE - Controlador Cougar/Manuais e Imagens/Espessura bobina rotor.jpg
