openrevoltse/Open-Revolt-SE/Projeto Open revolt SE - Controlador Cougar/Manuais e Imagens/Posicao capacitores.jpg

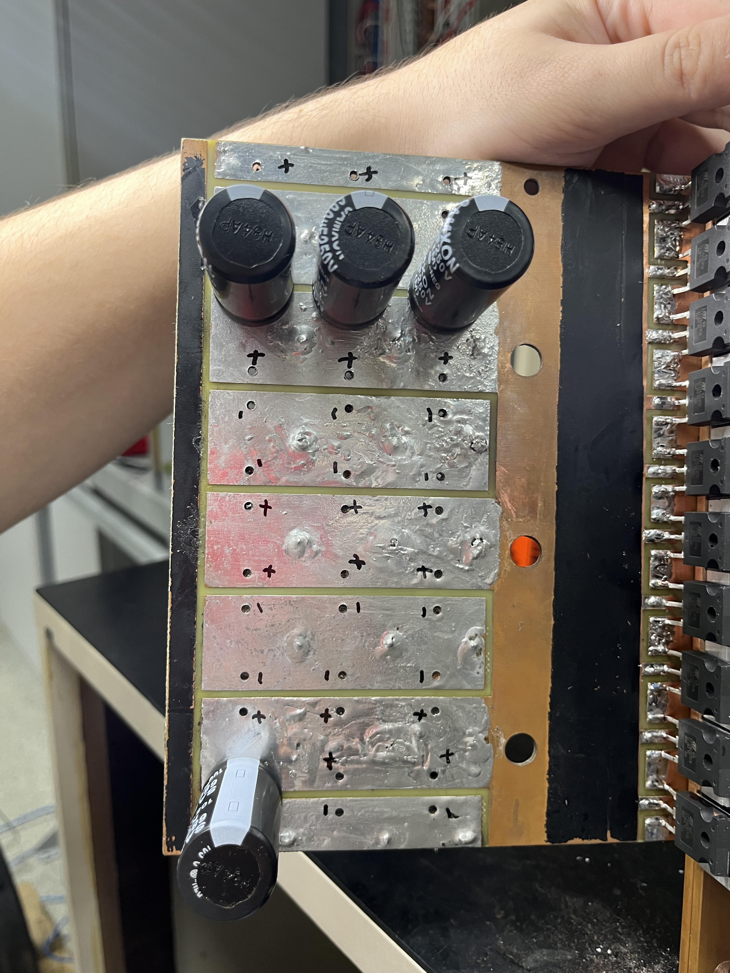
Projeto Open revolt SE - Controlador Cougar/Manuais e Imagens/Posicao capacitores.jpg
