openrevoltse/Open-Revolt-SE/Projeto Open revolt SE - Controlador Cougar/Manuais e Imagens/Contator e shunt.jpg

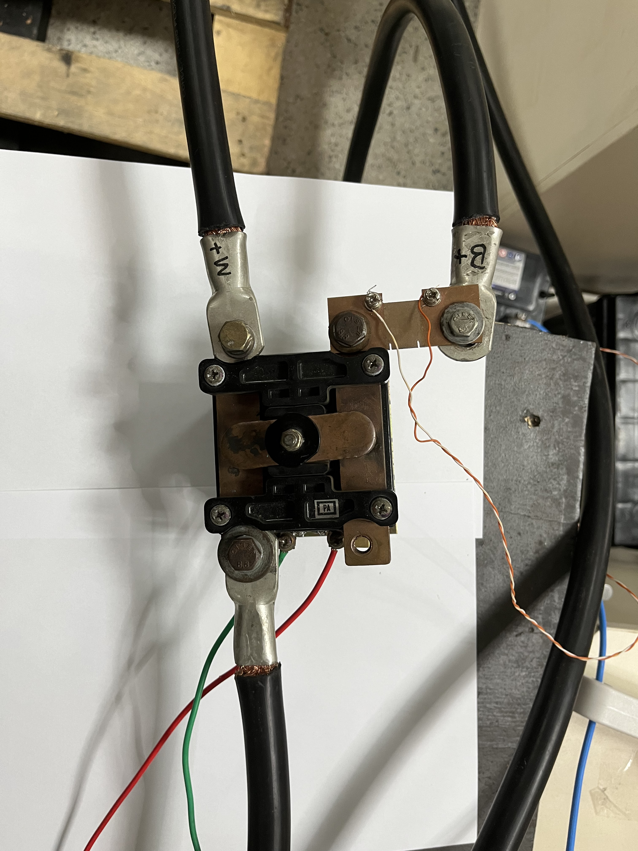
Projeto Open revolt SE - Controlador Cougar/Manuais e Imagens/Contator e shunt.jpg
